Engimusing/emus_hackadayprize/LED_Light_Drive.brd

## EAGLE design LED_Light_Drive.brd (2015-08-15)

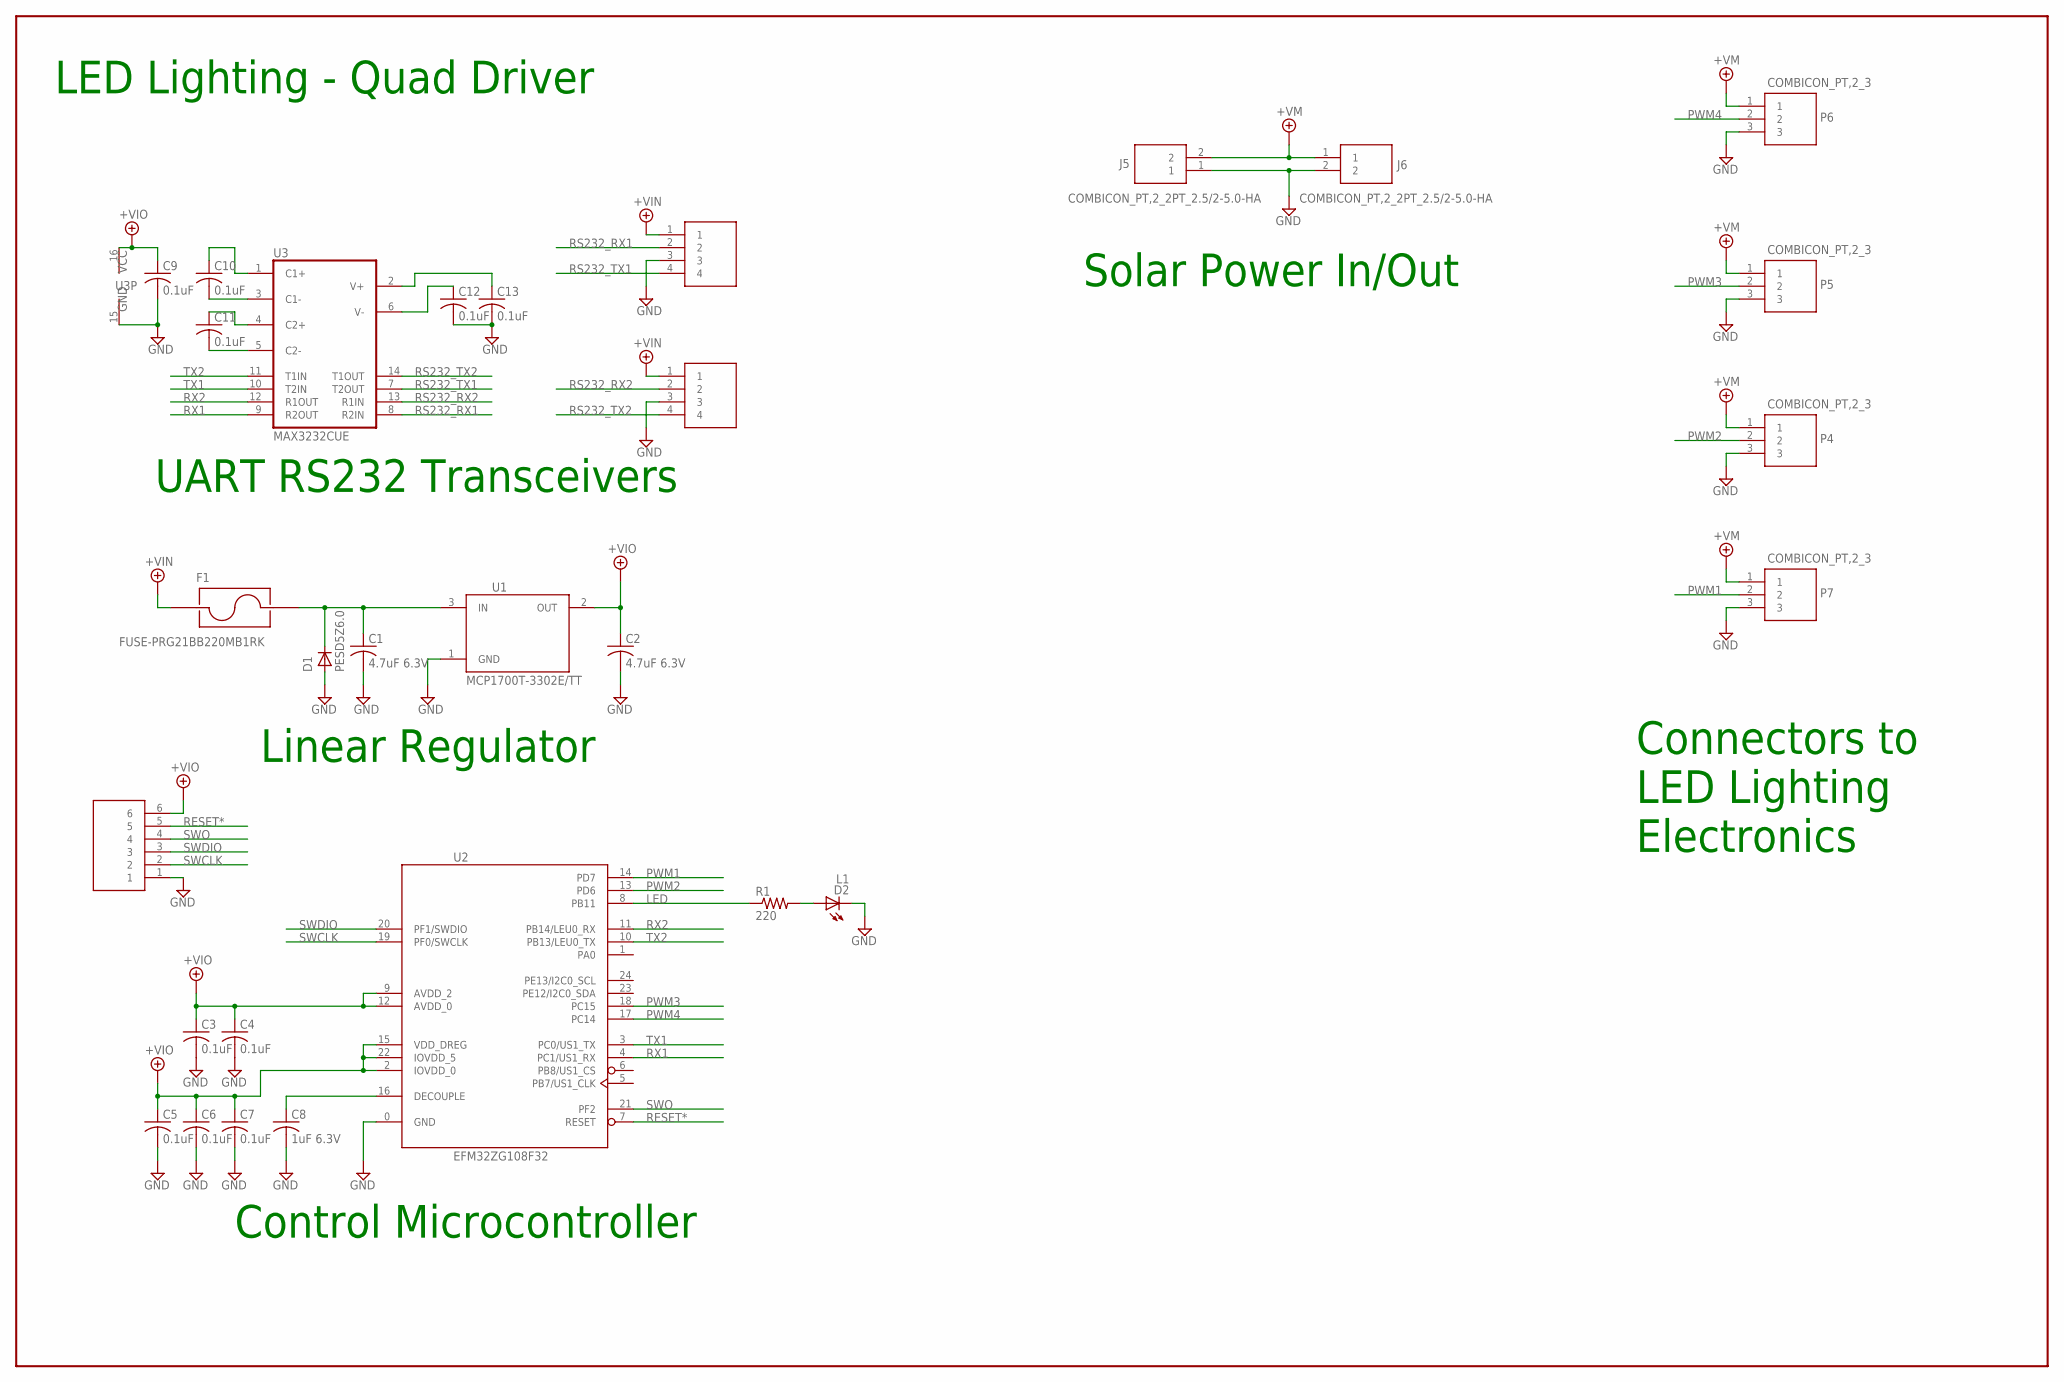
[picture p9: schematic LED_Light_Drive.sch]

Parts:
C1, C2: 4.7uF 6.3V; C0603
C3, C4, C5, C6, C7, C9, C10, C11, C12, C13: 0.1uF; C0402
C8: 1uF 6.3V; C0603
D1: PESD5Z6.0; SOD-523
D2: L1; CHIP-LED0603
F1: FUSE-PRG21BB220MB1RK; L0805_2.5
J5, J6: COMBICON_PT,2_2PT_2.5/2-5.0-HA; PT_2,5/2-5.0-HA
P1, P2: DF11-4_STRAIGHT_PIN; DF11SP-4-H
P3: DF11-6_STRAIGHT_PIN; DF11SP-6-H
P4, P5, P6, P7: COMBICON_PT,2_3; PT_2,5/3-5,0-H
R1: 220; R0402
U1: MCP1700T-3302E/TT; SOT23A
U2: EFM32ZG108F32; QFN24_5X5
U3: MAX3232CUE; TSSOP16

Connections:
+VIN: F1.2 (A), P1.1, P2.1
+VIO: C2.1, C3.1, C4.1, C5.1, C6.1, C7.1, C9.1, P3.6, U1.2 (OUT), U2.2 (IOVDD_0), U2.9 (AVDD_2), U2.12 (AVDD_0), U2.15 (VDD_DREG), U2.22 (IOVDD_5), U3.16 (VCC)
+VM: J5.2, J6.1, P4.1, P5.1, P6.1, P7.1
GND: C1.2, C2.2, C3.2, C4.2, C5.2, C6.2, C7.2, C8.2, C9.2, C12.2, C13.2, D1.A, D2.C, J5.1, J6.2, P1.3, P2.3, P3.1, P4.3, P5.3, P6.3, P7.3, U1.1 (GND), U2.0 (GND), U3.15 (GND)
LED: R1.1, U2.8 (PB11)
unnamed: C8.1, U2.16 (DECOUPLE)
unnamed: D2.A, R1.2
unnamed: C10.2, U3.3 (C1-)
unnamed: C10.1, U3.1 (C1+)
unnamed: C11.2, U3.5 (C2-)
unnamed: C11.1, U3.4 (C2+)
unnamed: C13.1, U3.2 (V+)
unnamed: C12.1, U3.6 (V-)
PWM1: P7.2, U2.14 (PD7)
PWM2: P4.2, U2.13 (PD6)
PWM3: P5.2, U2.18 (PC15)
PWM4: P6.2, U2.17 (PC14)
RESET*: P3.5, U2.7 (RESET)
RS232_RX1: P2.2, U3.8 (R2IN)
RS232_RX2: P1.2, U3.13 (R1IN)
RS232_TX1: P2.4, U3.7 (T2OUT)
RS232_TX2: P1.4, U3.14 (T1OUT)
RX1: U2.4 (PC1/US1_RX), U3.9 (R2OUT)
RX2: U2.11 (PB14/LEU0_RX), U3.12 (R1OUT)
SWCLK: P3.2, U2.19 (PF0/SWCLK)
SWDIO: P3.3, U2.20 (PF1/SWDIO)
SWO: P3.4, U2.21 (PF2)
TX1: U2.3 (PC0/US1_TX), U3.10 (T2IN)
TX2: U2.10 (PB13/LEU0_TX), U3.11 (T1IN)
VIN: C1.1, D1.K (C), F1.1 (B), U1.3 (IN)

Notes on the sheet:
UART RS232 Transceivers
LED Lighting - Quad Driver
Connectors to LED Lighting Electronics
Solar Power In/Out
Control Microcontroller
Linear Regulator

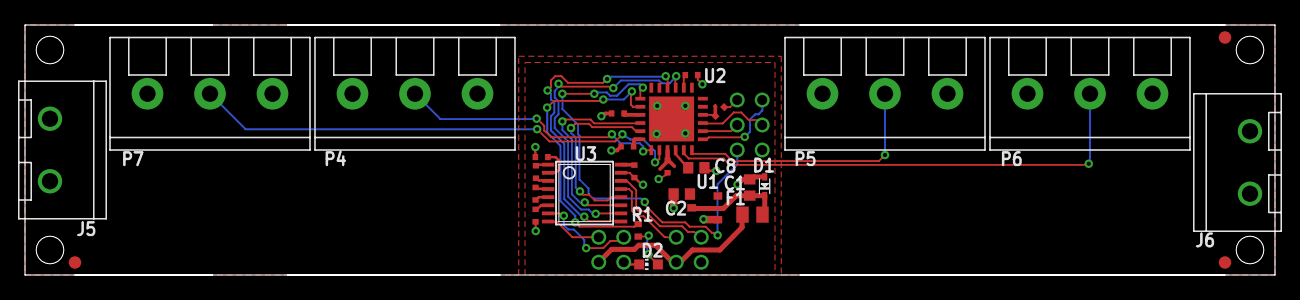
[picture p10: board LED_Light_Drive.brd from above]

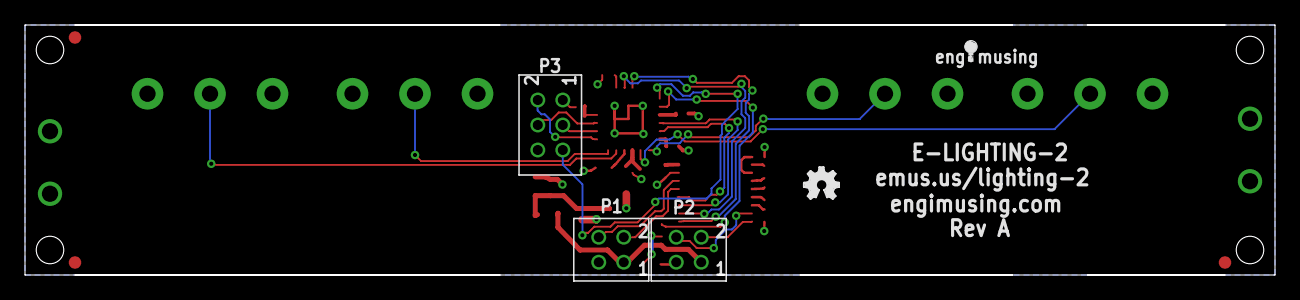
[picture p11: board LED_Light_Drive.brd from below]

Board: 2 copper layers, 100.0 x 20.0 mm, 34 parts (5 on the bottom side), 30 nets.

Other parts of the board:
U$1, U$2, U$5: FIDUCIAL_G10
U$3: OSHW_FILLX100_NOTEXT
U$4: LOGO
