Engimusing/emus_hackadayprize/LED_Light_Bulb.brd

## EAGLE design LED_Light_Bulb.brd (2015-08-15)

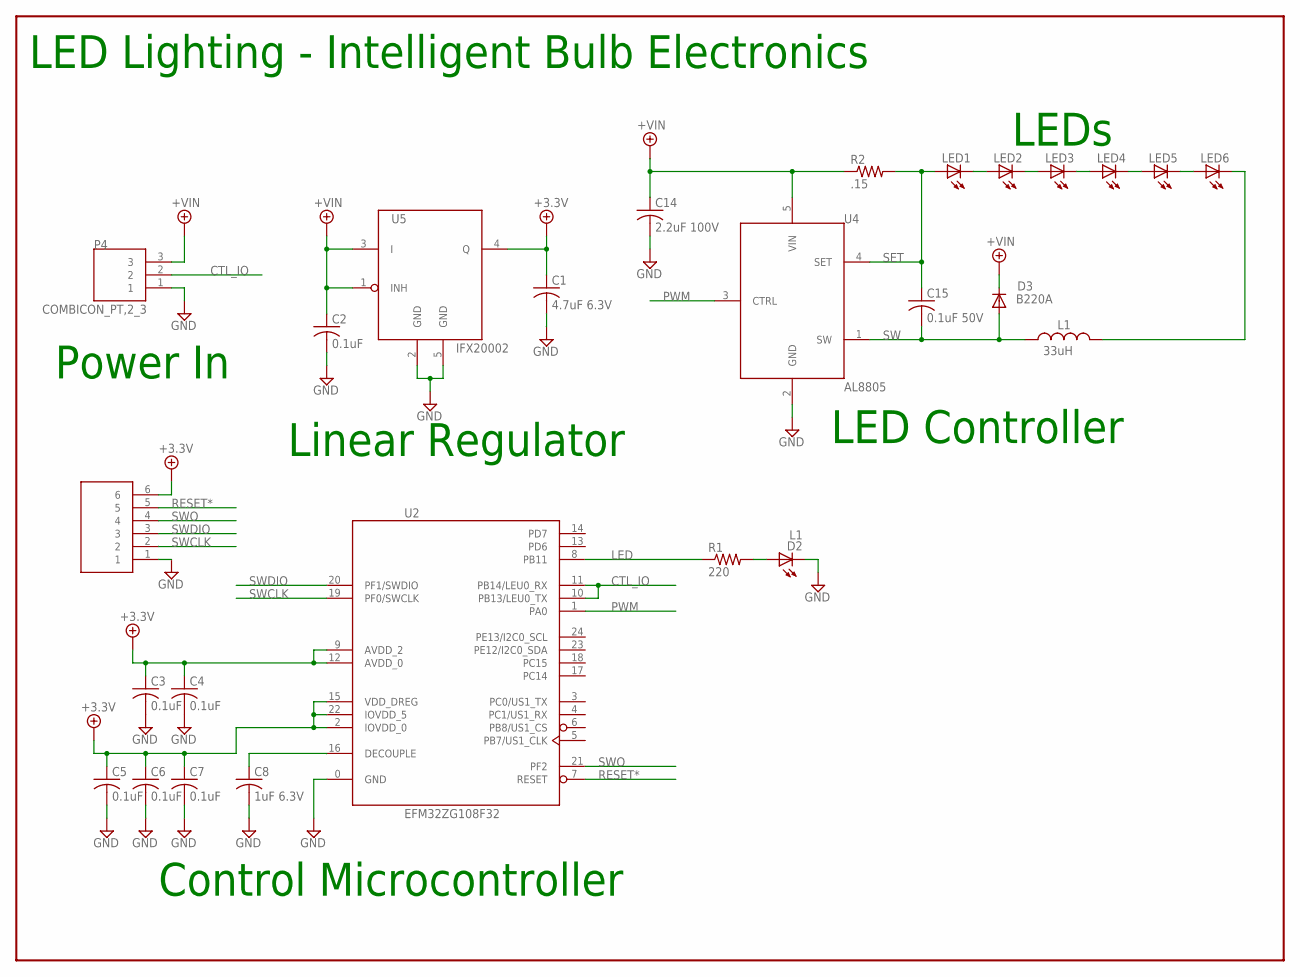
[picture p12: schematic LED_Light_Bulb.sch]

Parts:
C1: 4.7uF 6.3V; C0603
C2, C3, C4, C5, C6, C7: 0.1uF; C0603
C8: 1uF 6.3V; C0603
C14: 2.2uF 100V; C1210K
C15: 0.1uF 50V; C0805
D2: L1; CHIP-LED0603
D3: B220A; DO214SMA
L1: 33uH; SRN6045
LED1, LED2, LED3, LED4, LED5, LED6: LED-MX3; LED_5X5
P3: DF11-6_STRAIGHT_PIN; DF11SP-6-H
P4: COMBICON_PT,2_3; PT_2,5/3-5,0-H
R1: 220; R0603
R2: .15; R0805
U2: EFM32ZG108F32; QFN24_5X5
U4: AL8805; SOT-23-5A
U5: IFX20002; PG-SCT595-5

Connections:
+3.3V: C1.1, C3.1, C4.1, C5.1, C6.1, C7.1, P3.6, U2.2 (IOVDD_0), U2.9 (AVDD_2), U2.12 (AVDD_0), U2.15 (VDD_DREG), U2.22 (IOVDD_5), U5.4 (Q)
+VIN: C2.1, C14.1, D3.1 (C), P4.3, R2.1, U4.5 (VIN), U5.1 (INH), U5.3 (I)
CTL_IO: P4.2, U2.10 (PB13/LEU0_TX), U2.11 (PB14/LEU0_RX)
GND: C1.2, C2.2, C3.2, C4.2, C5.2, C6.2, C7.2, C8.2, C14.2, D2.C, P3.1, P4.1, U2.0 (GND), U4.2 (GND), U5.2 (GND), U5.5 (GND)
LED: R1.1, U2.8 (PB11)
unnamed: C8.1, U2.16 (DECOUPLE)
unnamed: L1.2, LED6.C
unnamed: D2.A, R1.2
unnamed: LED1.C, LED2.A
unnamed: LED2.C, LED3.A
unnamed: LED3.C, LED4.A
unnamed: LED4.C, LED5.A
unnamed: LED5.C, LED6.A
PWM: U2.1 (PA0), U4.3 (CTRL)
RESET*: P3.5, U2.7 (RESET)
SET: C15.1, LED1.A, R2.2, U4.4 (SET)
SW: C15.2, D3.2 (A), L1.1, U4.1 (SW)
SWCLK: P3.2, U2.19 (PF0/SWCLK)
SWDIO: P3.3, U2.20 (PF1/SWDIO)
SWO: P3.4, U2.21 (PF2)

Notes on the sheet:
LED Lighting - Intelligent Bulb Electronics
Power In
Linear Regulator
Control Microcontroller
LED Controller
LEDs

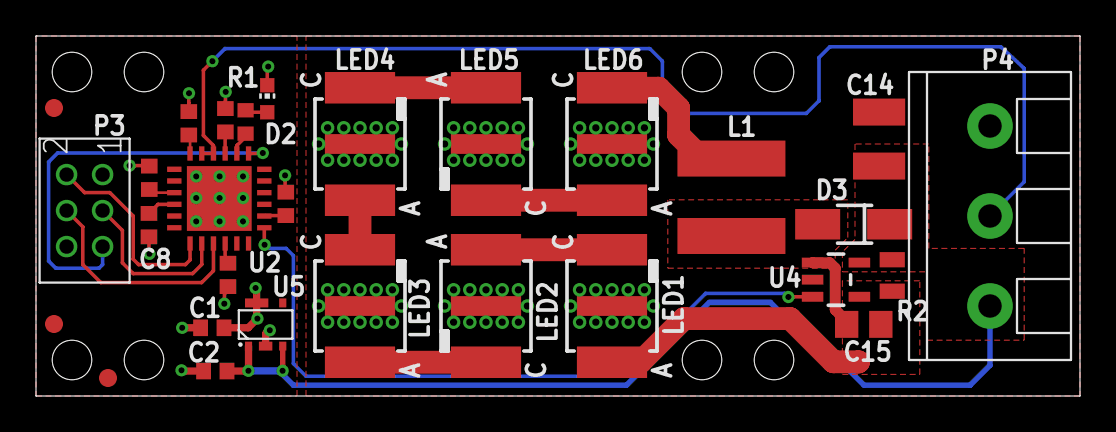
[picture p13: board LED_Light_Bulb.brd from above]

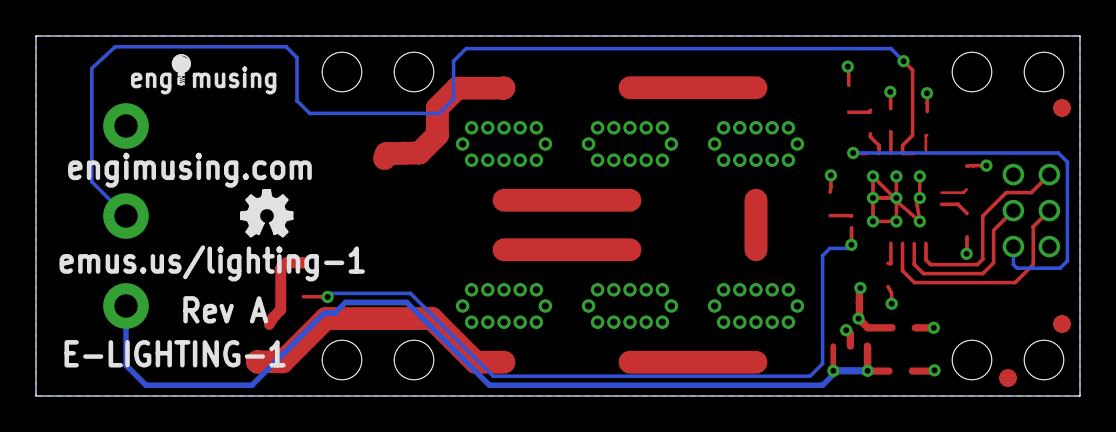
[picture p14: board LED_Light_Bulb.brd from below]

Board: 2 copper layers, 58.0 x 20.0 mm, 31 parts (2 on the bottom side), 20 nets.

Other parts of the board:
U$1, U$2, U$5: FIDUCIAL_G10
U$3: OSHW_FILLX100_NOTEXT
U$4: LOGO
