Engimusing/emus_hackadayprize/(notices)

Notices in the files:
parts and their libraries:
dicons: Copyright (C) 2004, Bob Starr (rtzaudio@mindspring.com)
Engimusing: Released under the Creative Commons
Attribution Share-Alike 4.0 License
https://creativecommons.org/licenses/by-sa/4.0
